momo1125076-afk/bearing-tube-generator/assets/donate.jpg

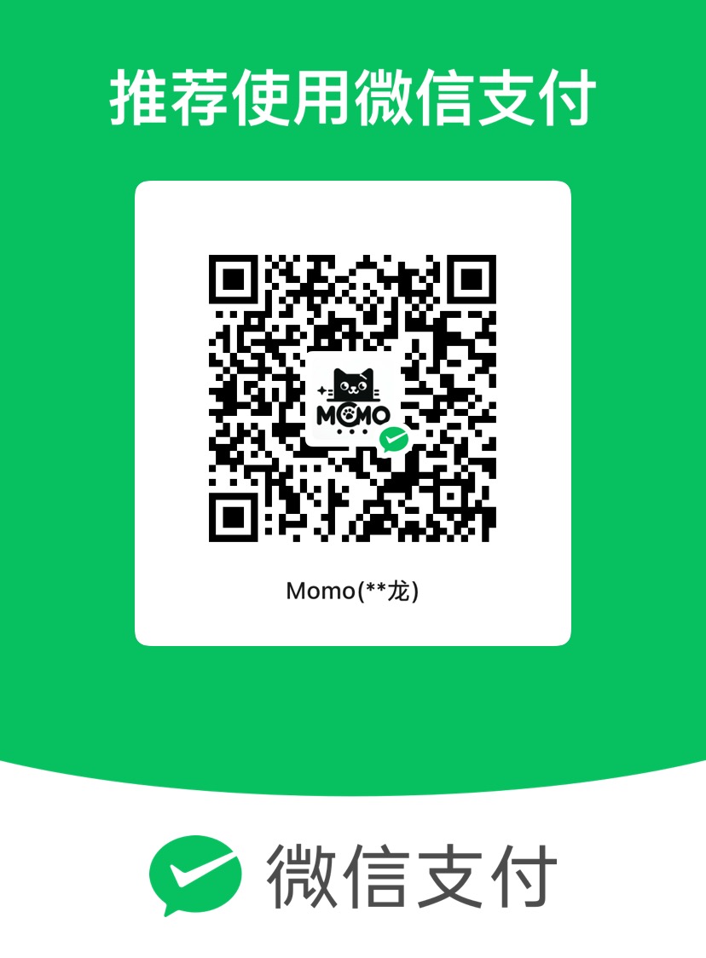
assets/donate.jpg
