momo1125076-afk/bearing-tube-generator/examples/default_assembly.step

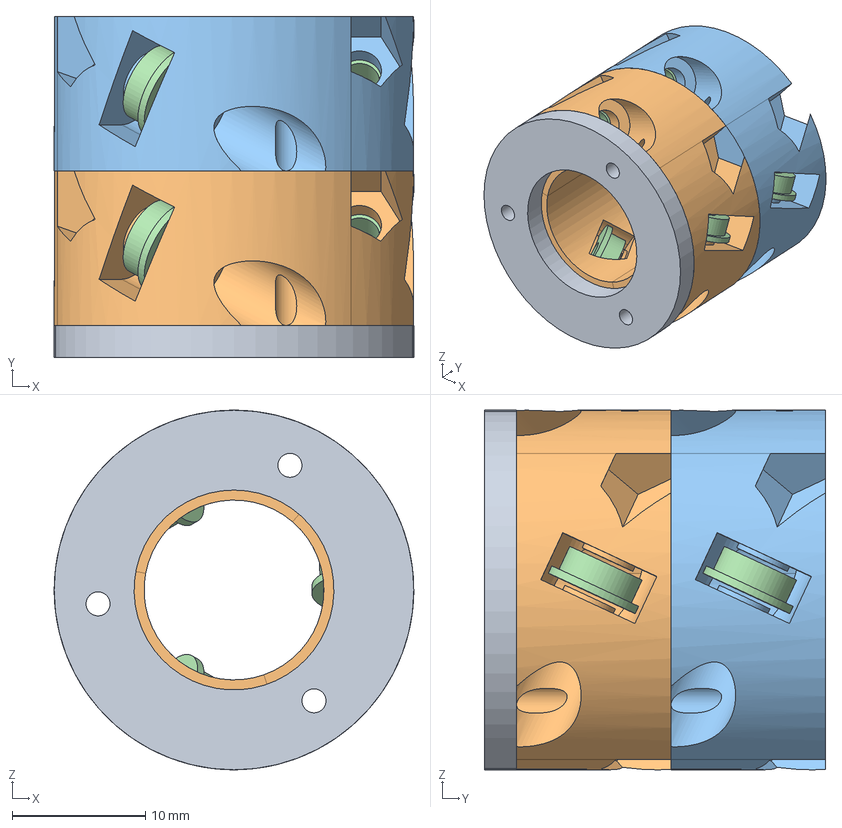
[picture p2: CAD file, 2026-10-30, last stored version]
examples/default_assembly.step
27.0 x 25.6 x 27.0 mm
