momo1125076-afk/bearing-tube-generator/examples/default_unit_kinds.stl

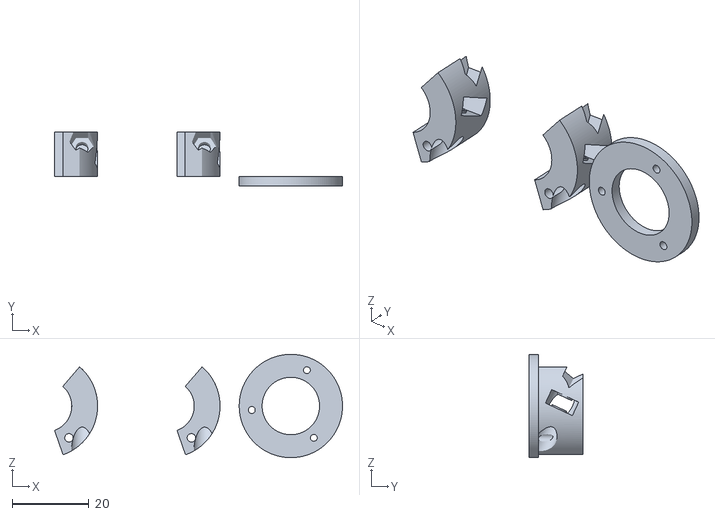
[picture p3: CAD file, 2026-10-30, last stored version]
examples/default_unit_kinds.stl
75.3 x 14.0 x 27.0
