momo1125076-afk/bearing-tube-generator/examples/bearing_MF63ZZ.step

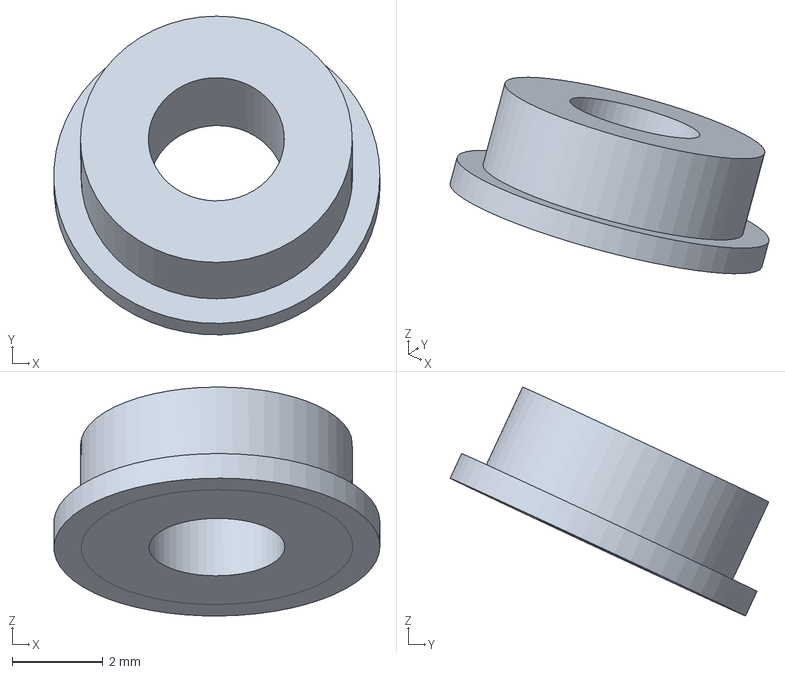
[picture p4: CAD file, 2026-10-30, last stored version]
examples/bearing_MF63ZZ.step
7.20 x 7.04 x 5.05 mm
