momo1125076-afk/bearing-tube-generator/examples/default_body.step

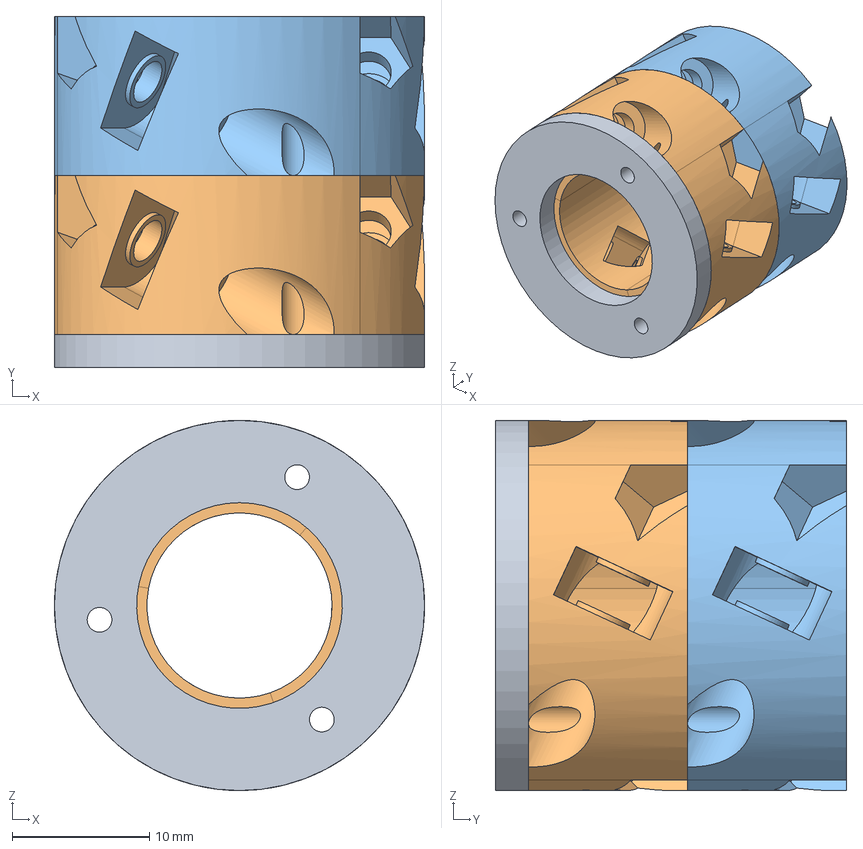
[picture p5: CAD file, 2026-10-30, last stored version]
examples/default_body.step
27.0 x 25.6 x 27.0 mm
