momo1125076-afk/bearing-tube-generator/examples/default_base.step

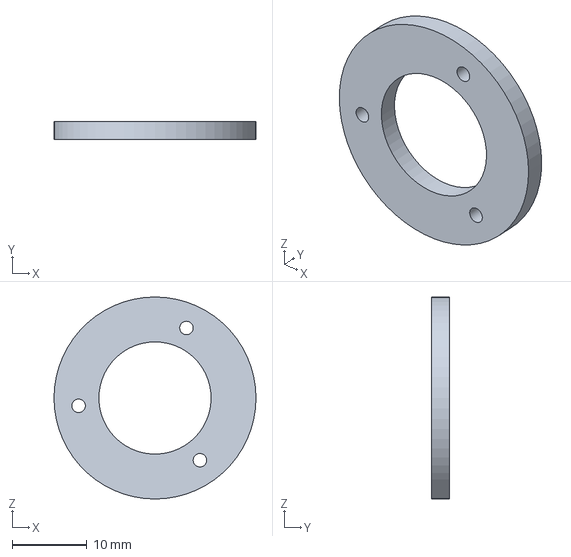
[picture p6: CAD file, 2026-10-30, last stored version]
examples/default_base.step
27.0 x 2.40 x 27.0 mm
