momo1125076-afk/bearing-tube-generator/examples/default_unit.step

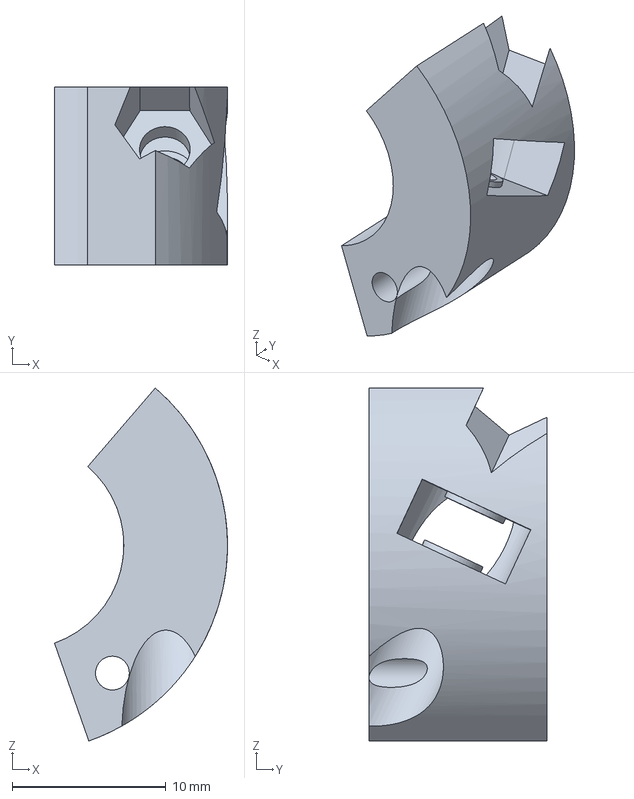
[picture p7: CAD file, 2026-10-30, last stored version]
examples/default_unit.step
11.3 x 11.6 x 23.0 mm
