momo1125076-afk/bearing-tube-generator/(list of files, cad)

Other CAD files:
examples/default_all_parts.stl
examples/default_base.stl
examples/default_unit.stl
