momo1125076-afk/bearing-tube-generator/(commit log)

2026-10-30 Initial bearing tube generator project
    [bearing_MF63ZZ.step, default_all_parts.stl, default_assembly.step, default_base.step, default_base.stl, default_body.step, default_unit.step, default_unit.stl]
2026-10-30 更新网页版：默认3层、斜面下移、圆形底座、融合/拆分导出、打印间隙、STEP导出提示、回归测试
    [bearing_MF63ZZ.step, default_all_parts.stl, default_assembly.step, default_base.step, default_base.stl, default_body.step, default_unit.step, default_unit.stl]
2026-10-30 v31：右上角收款码与授权声明/微信号；贯通螺丝补强孔(reinfHoleD 默认2.5,0=无)；外形对齐参考STEP；层间距离/外径参数；回归测试
2026-10-30 收款码直接展开显示在导出区授权声明下方（不再悬浮/折叠），更新测试与 README
2026-10-30 添加 LICENSE（中英双语非商业授权）、GitHub 开源地址与 Star 提示，更新测试
2026-11-01 v35：快拆轴承底座（平盖板/卡扣2-6/弹簧座5x10x0.4/管口加粗环/盖板外径参数）、装饰外壳+M2固定+花纹、测试
2026-11-01 v41: 快拆卡扣强度对齐内管座（总截面≥227.9mm²，厚4.5）
2026-11-02 v42: 快拆底座保留原 STEP 管口卡圈固定（管插孔Ø16.5+卡圈槽Ø20×1.3，可调；打印C形卡圈导出），测试与README
